kevinaangstadt/8088_breadboard_computer/README.md

# 8088 Breadboard Computer

This is a design for an 16-bit computer built around an Intel 80C88 processor.
