kevinaangstadt/8088_breadboard_computer/software/interrupt/README.md

# Verify RAM and ROM

This directory contains a ROM that will set up a timer and print a count that
increments approximately every second.

It will require the following to be working:

- 8284A clock generator
- 80C88 processor
- Address latching
- Data buffering
- IO/M̅ decoding and buffering
- Upper 8K ROM
- Upper and Lower RAM
- 80C55 PIO
- 1602 LCD Module
- 82C59A PIC and associated data buffer logic
- 82C54 timer chip
