kevinaangstadt/8088_breadboard_computer/hardware/8088_breadboard_computer.pdf

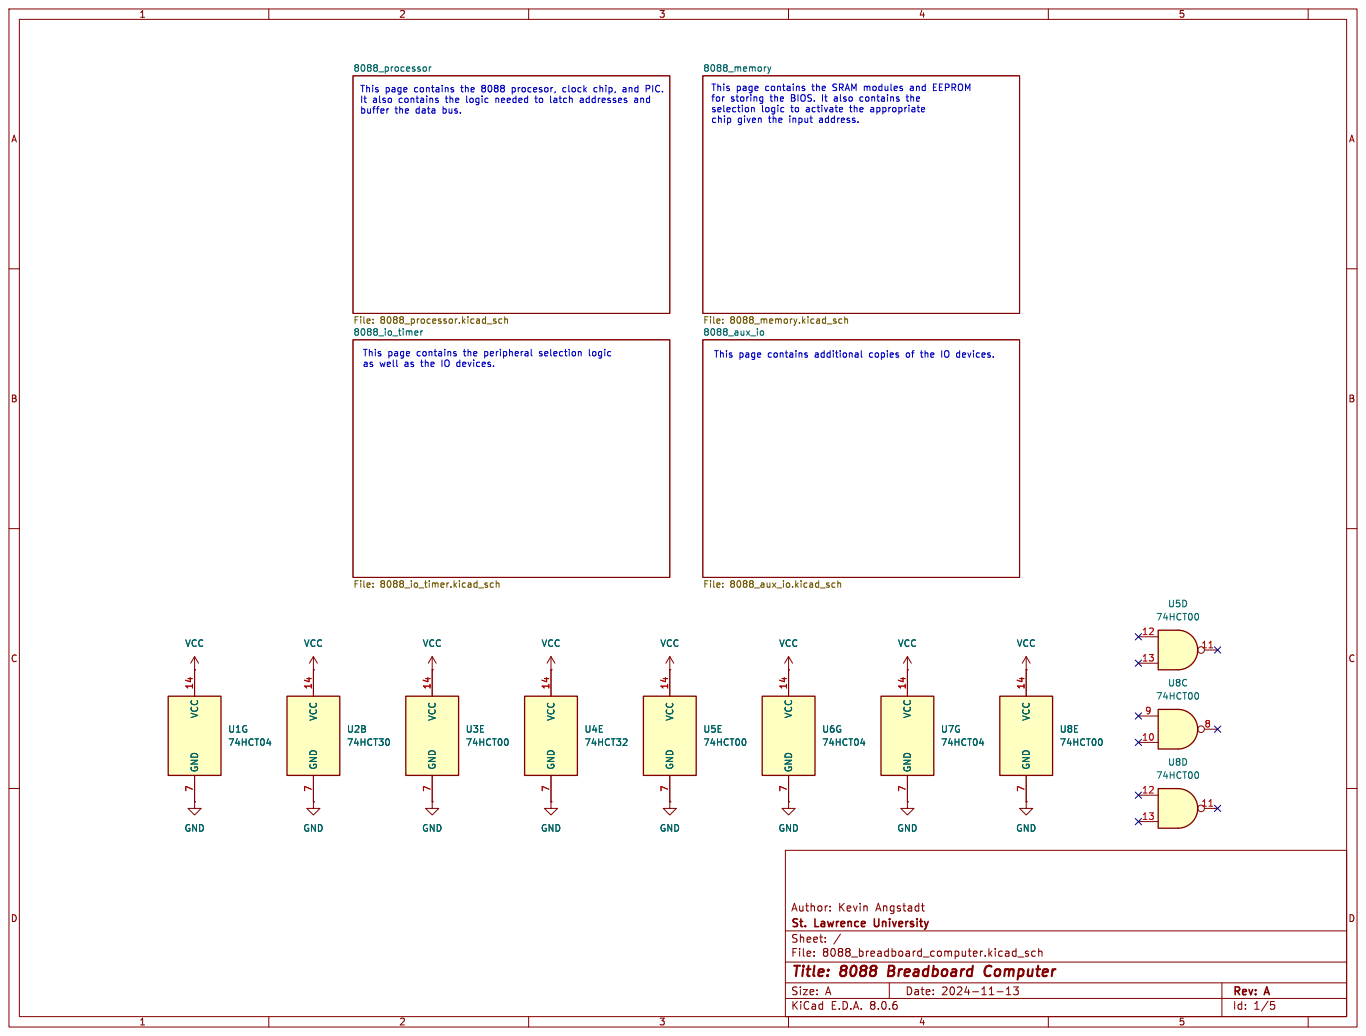
[picture p1: page 1]

VCC GND VCC 14 GND

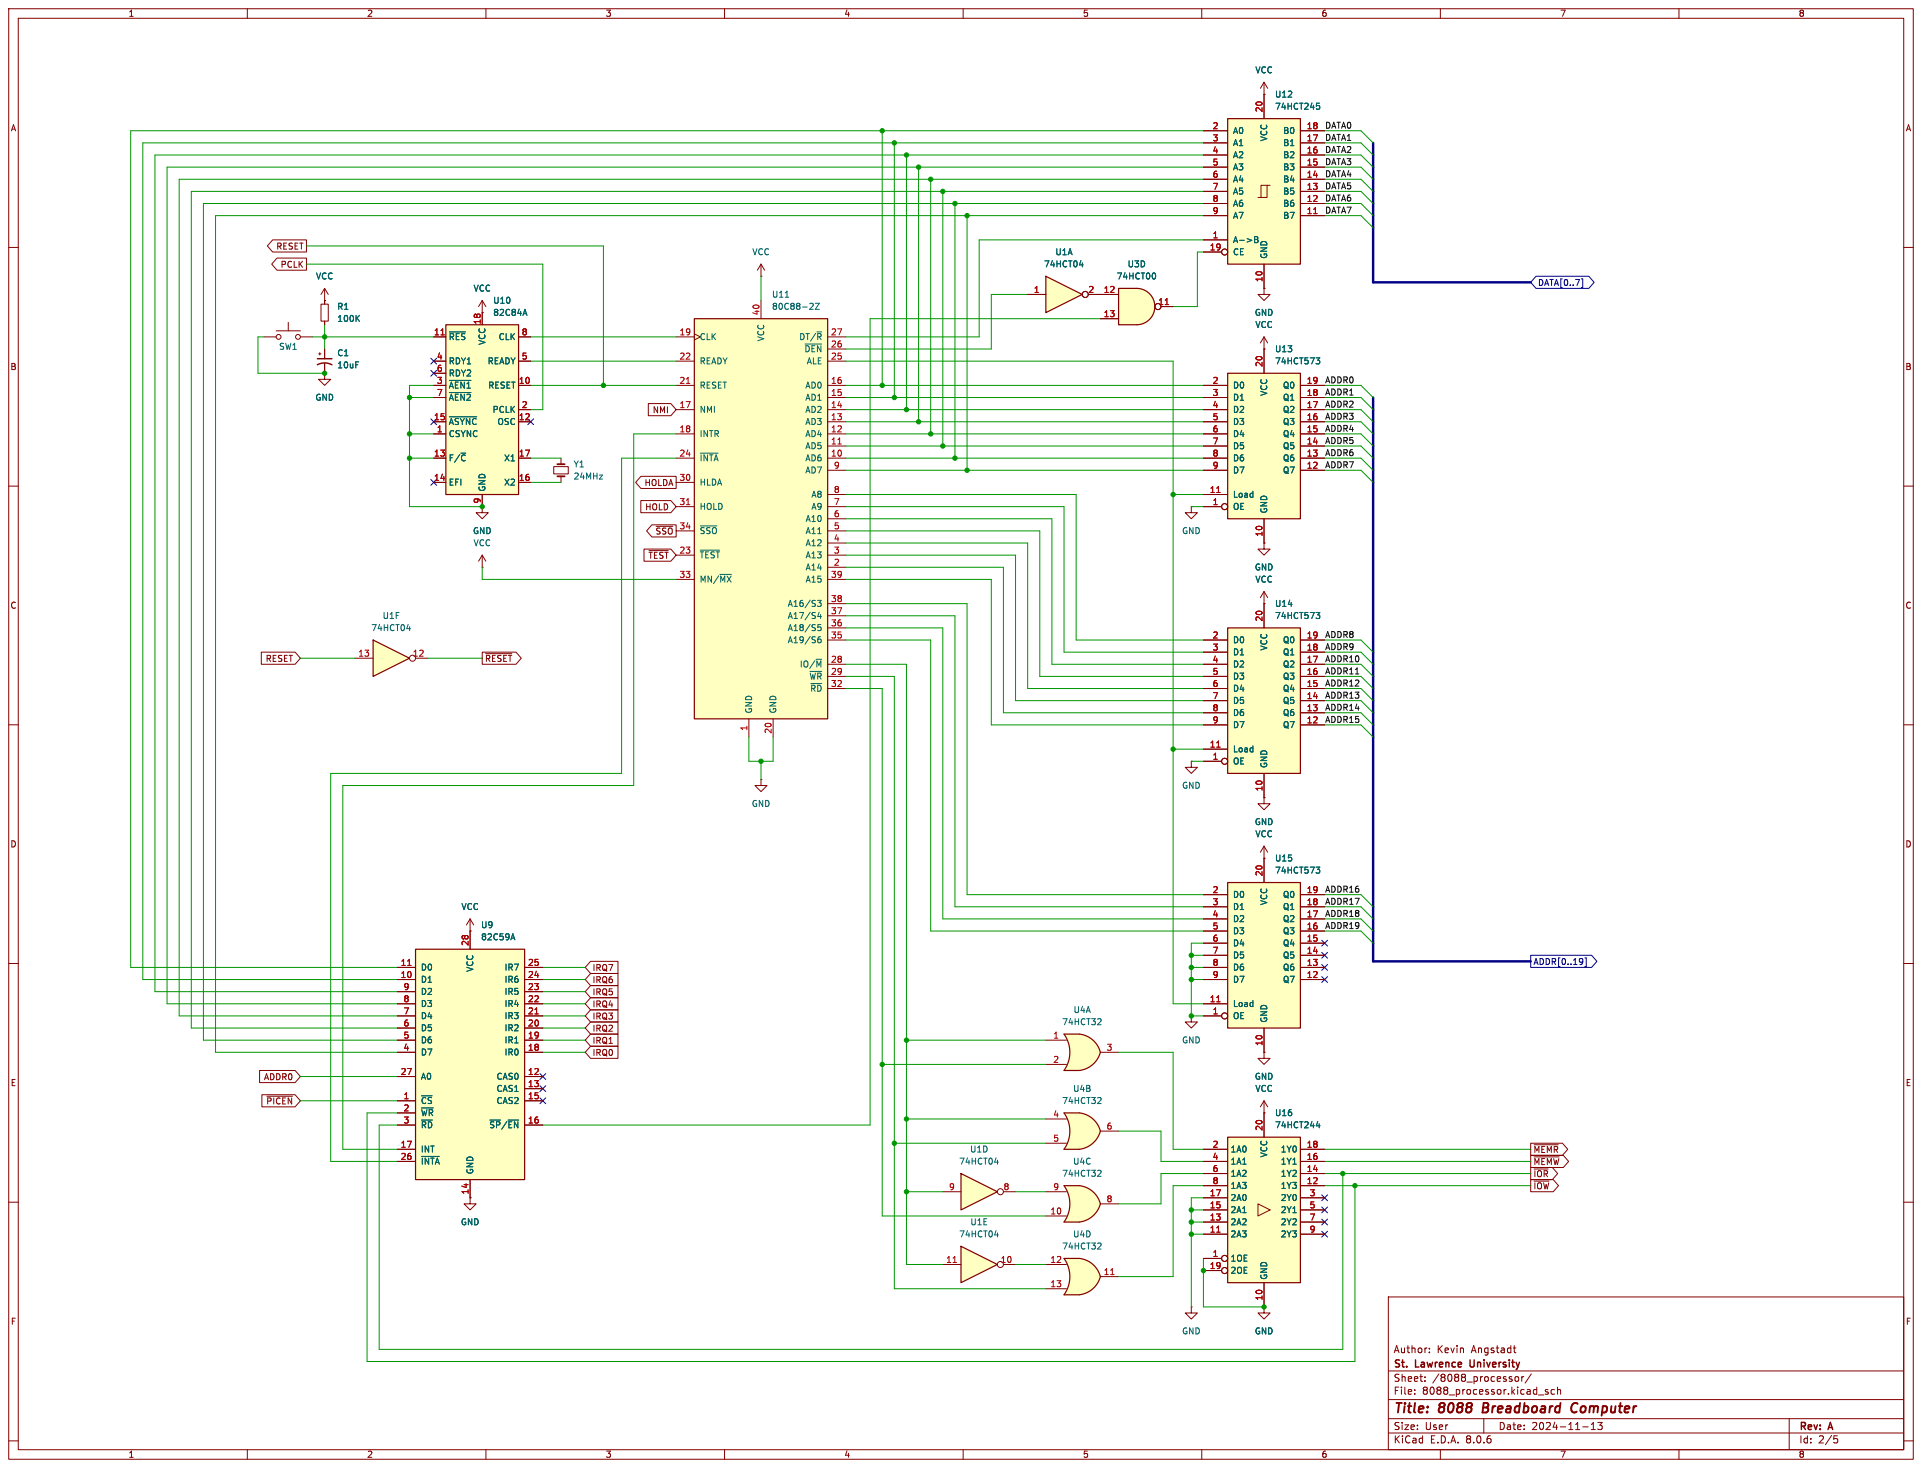
[picture p2: page 2]

Id: 2/5 Title: 8088 Breadboard Computer File: 8088_processor.kicad_sch Sheet: /8088_processor/ St. Lawrence University Author: Kevin Angstadt

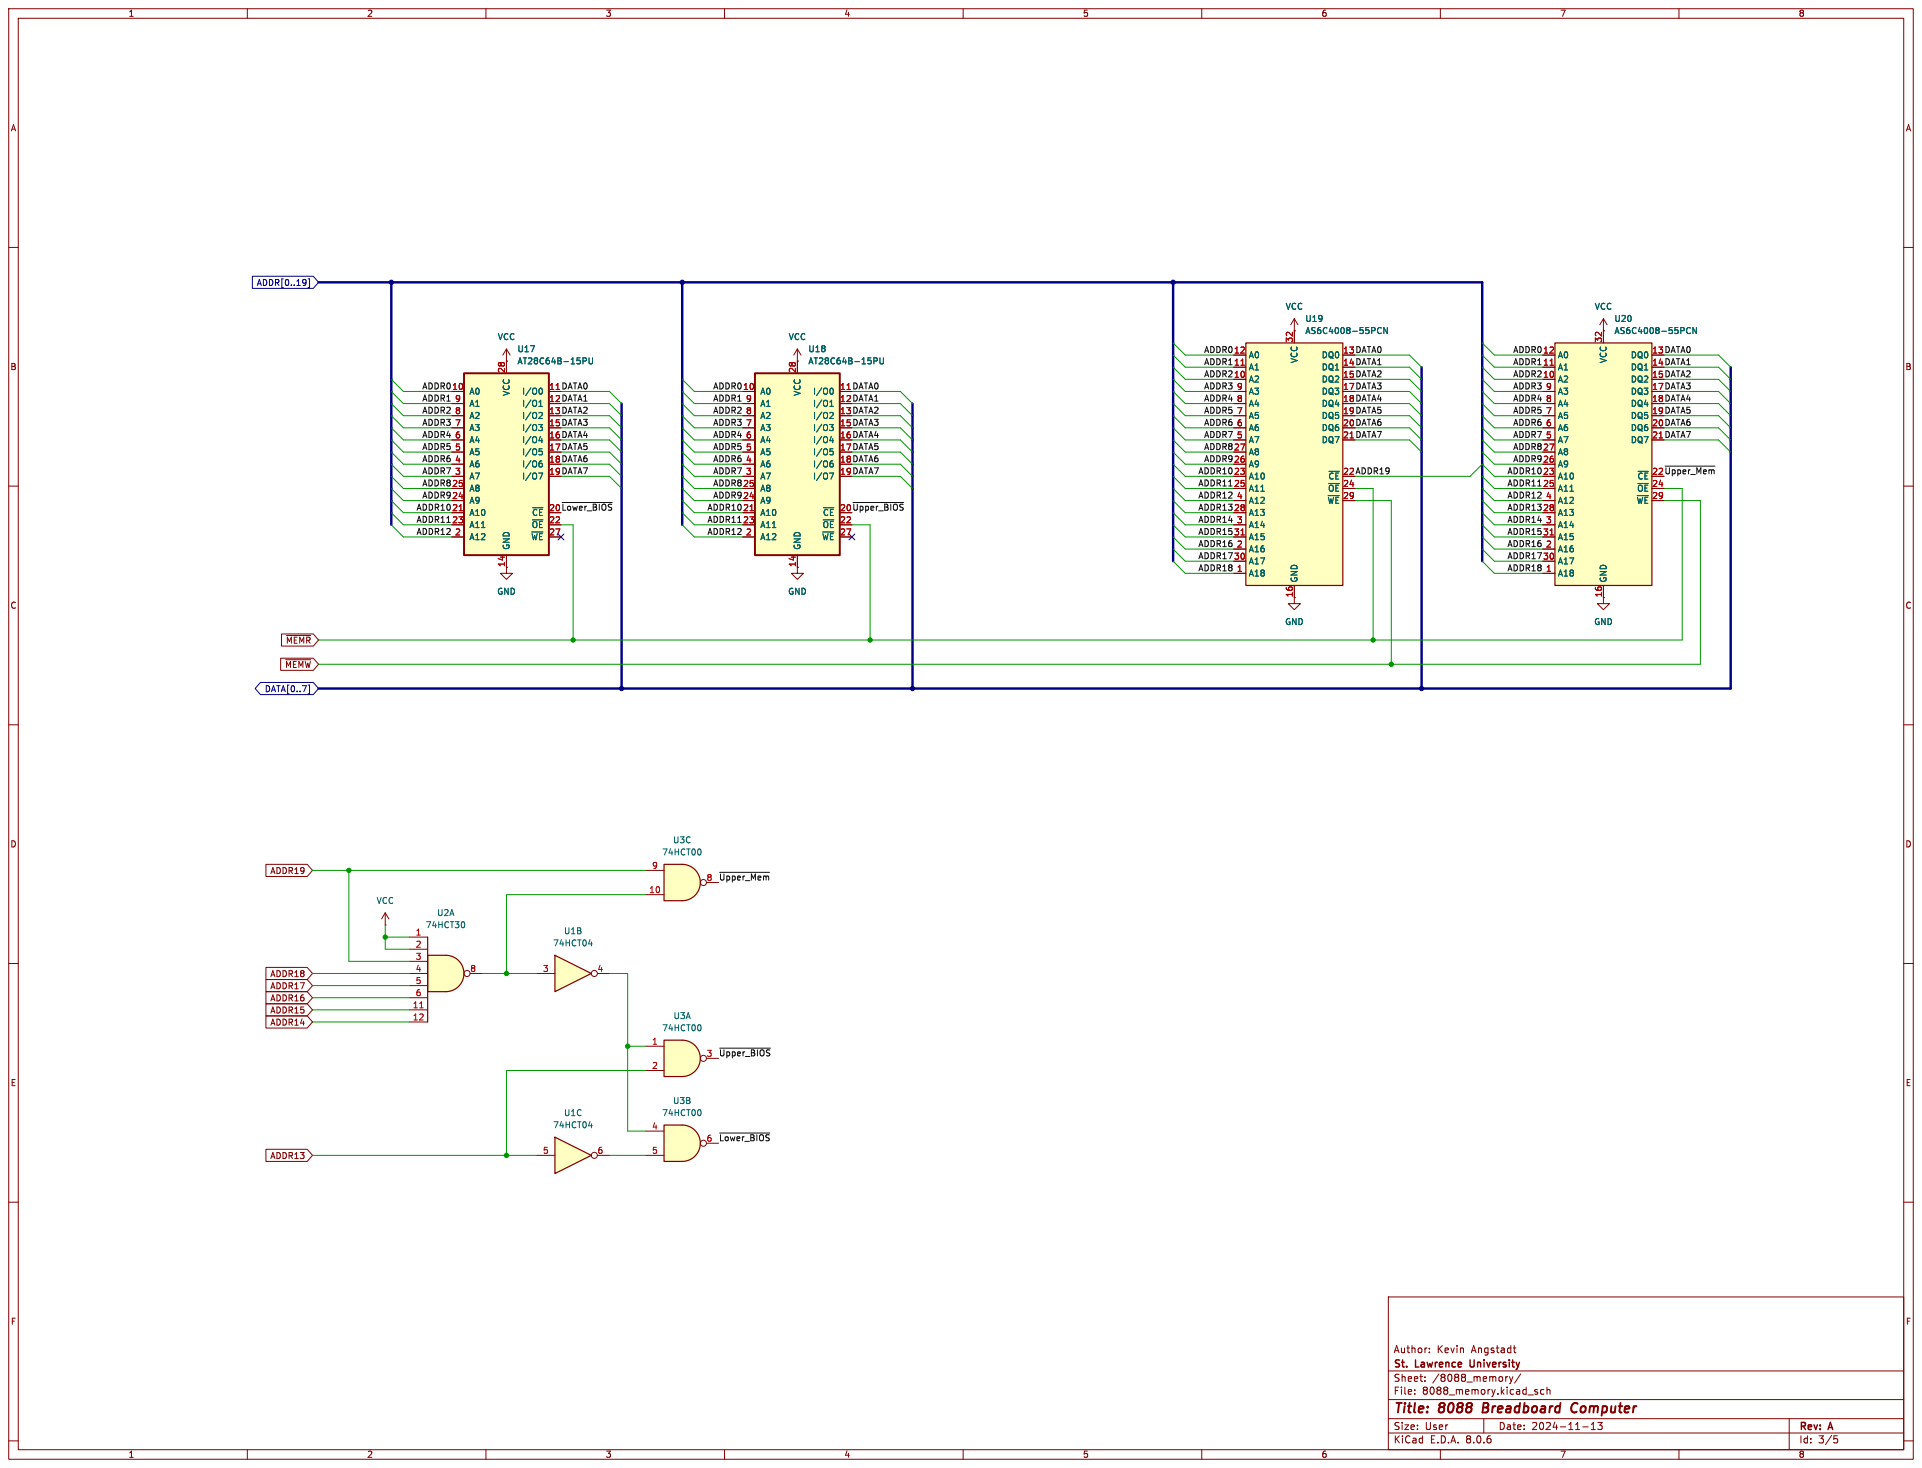
[picture p3: page 3]

Id: 3/5 Title: 8088 Breadboard Computer File: 8088_memory.kicad_sch Sheet: /8088_memory/ St. Lawrence University Author: Kevin Angstadt

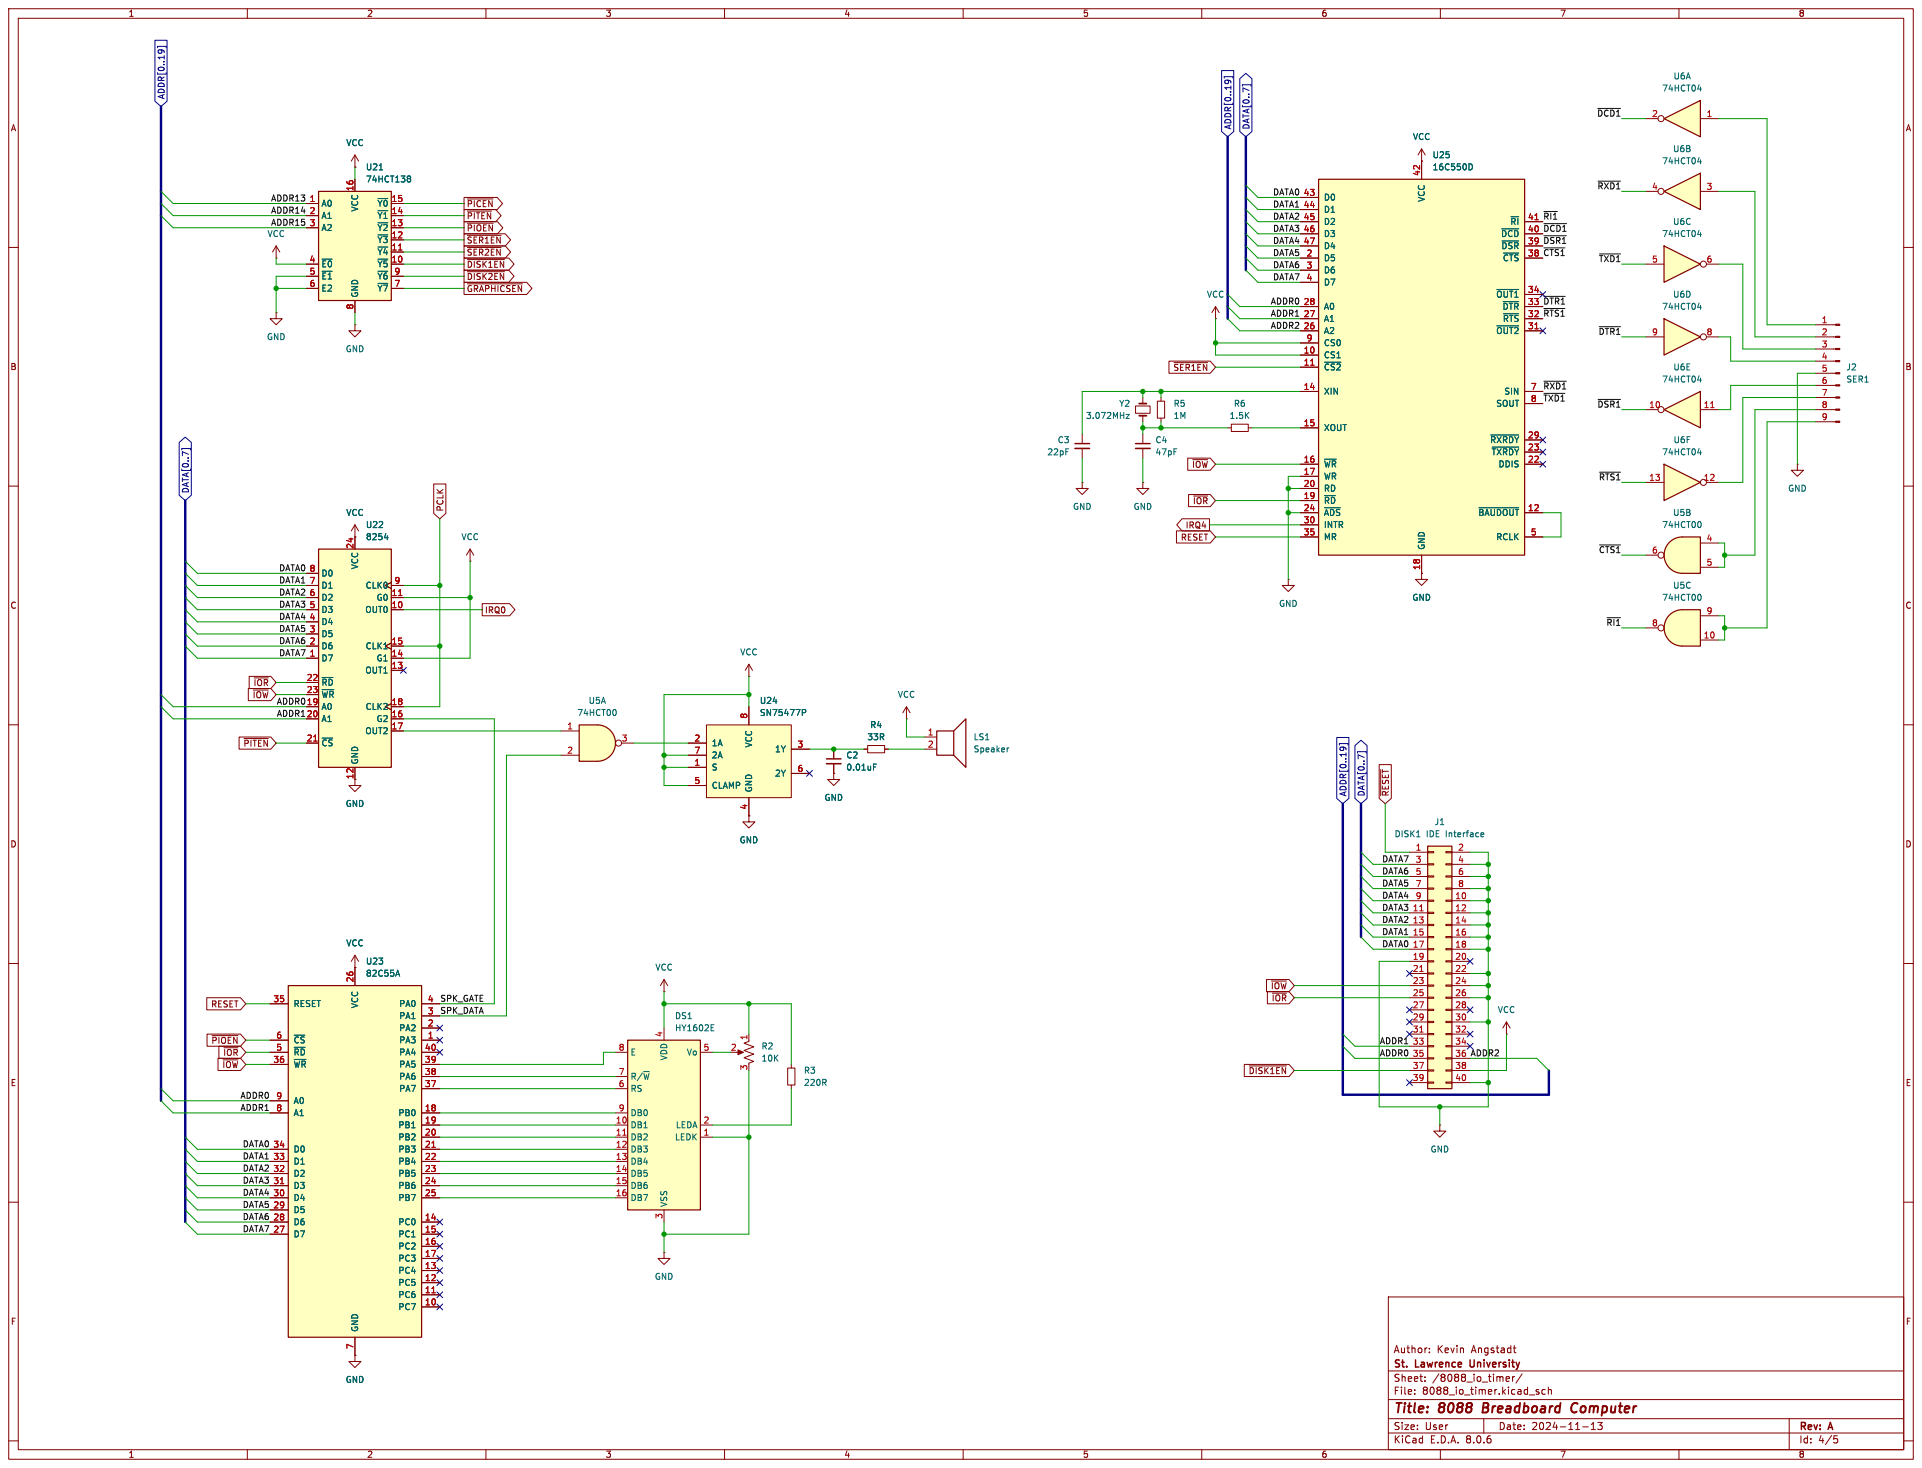
[picture p4: page 4]

Id: 4/5 Title: 8088 Breadboard Computer File: 8088_io_timer.kicad_sch Sheet: /8088_io_timer/ St. Lawrence University Author: Kevin Angstadt

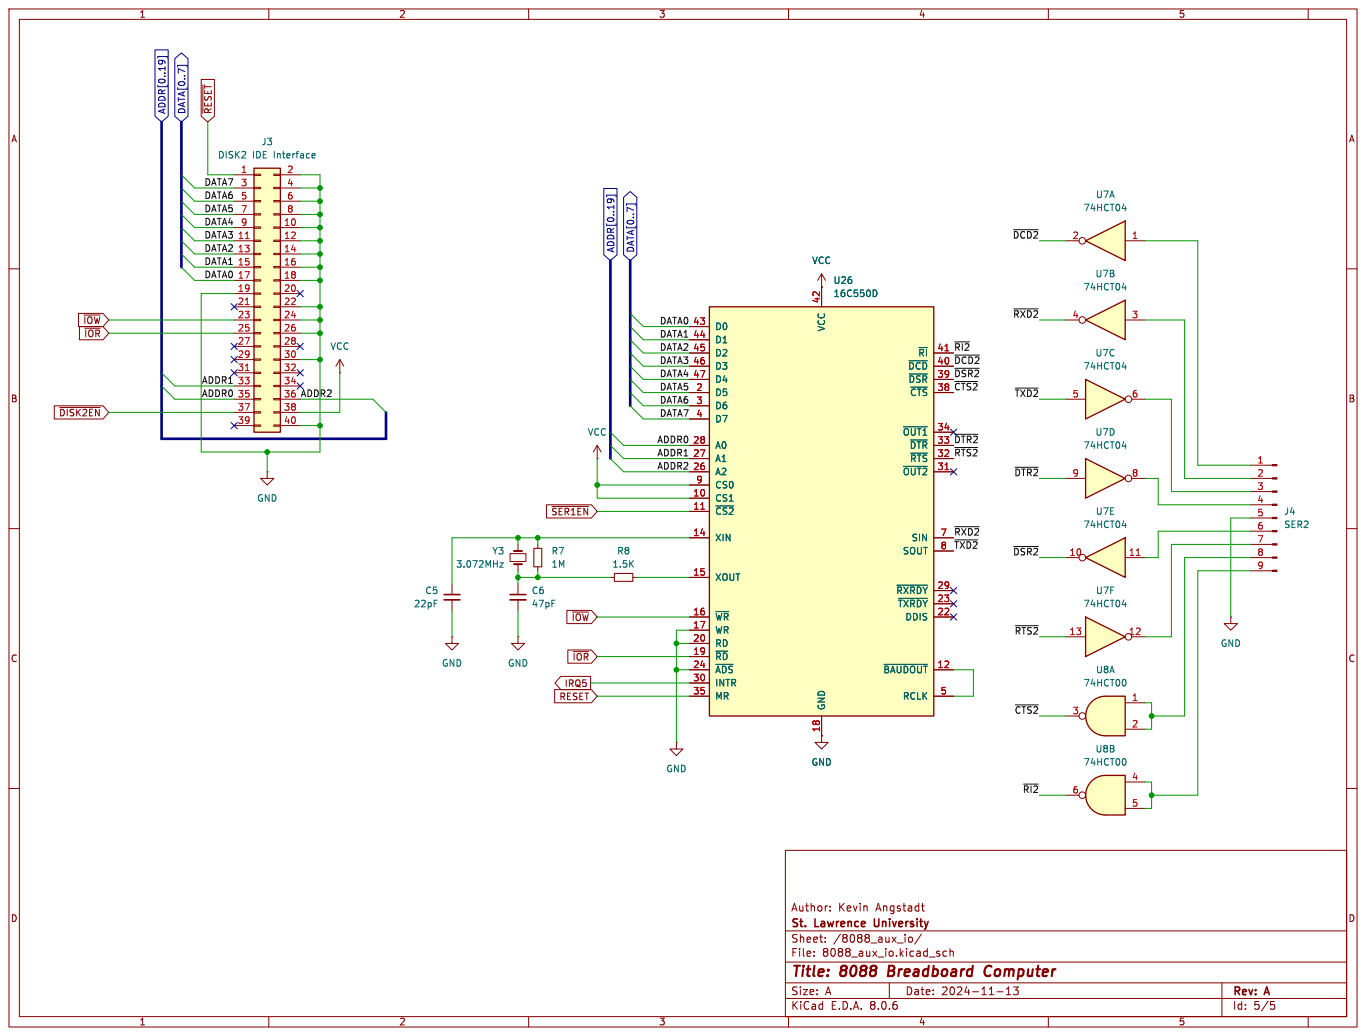
[picture p5: page 5]
