kevinaangstadt/8088_breadboard_computer/(list of files, drawings)

Other design files:
hardware/1mb_16kb_decode.circ
