kevinaangstadt/8088_breadboard_computer/(commit log)

2024-11-25 Move to a hardware directory
    [1mb_16kb_decode.circ, 8088_aux_io.kicad_sch, 8088_breadboard_computer.kicad_pcb, 8088_breadboard_computer.kicad_sch, 8088_io_timer.kicad_sch, 8088_memory.kicad_sch, 8088_processor.kicad_sch]
2024-12-09 Using the timer for a beep
2025-01-01 Fixed improved hello world
    [hello-improved.asm]
2025-01-02 Set the address for comparison correctly.
    [crc.asm]
2025-01-02 CRC must be stored in LE form. A few other fixes.
    [crc.asm]
2025-01-09 Bug fixes and debugging
    [memcheck.asm]
2025-01-12 Add an interrupt example
2025-01-22 Basic UART tests
